jonardan/tapbot/hardware/plotter-5bar/fusion/Plotter5Bar_M4.step

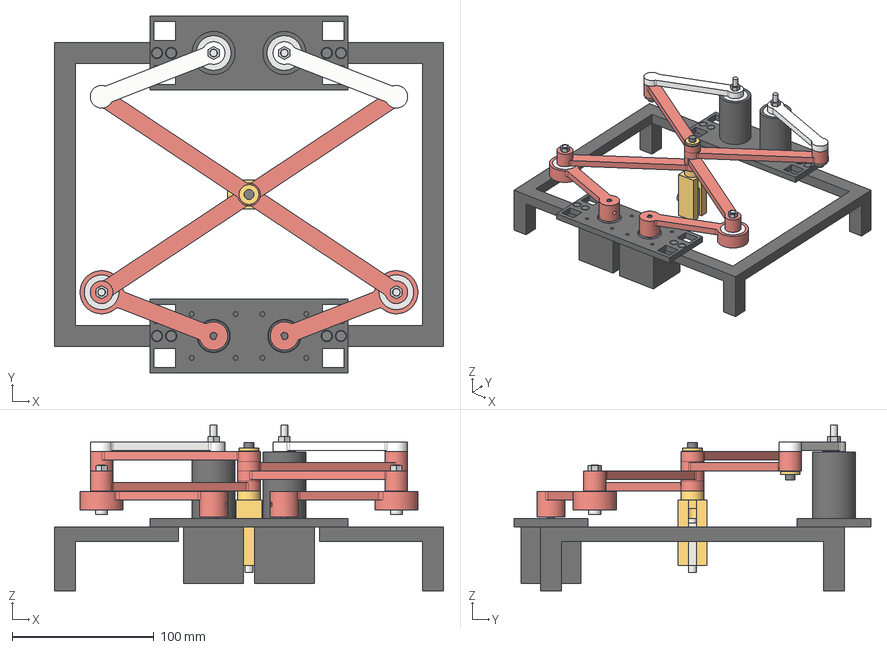
[picture p6: CAD file, 2026-11-05]
hardware/plotter-5bar/fusion/Plotter5Bar_M4.step
275.0 x 252.3 x 117.0 mm
MotorMount
PivotMount
Rail x 2
ProximalArm x 2
DistalArm x 4
PassiveProximalArm x 2
EffectorHub_SolenoidHolder
M5Sleeve x 2
PinCap x 3
PURCHASED_NEMA17 x 2
PURCHASED_Bearing x 4
PURCHASED_Solenoid_JF0530B
PURCHASED_M5x30 x 4
PURCHASED_M5_Nut x 4
PURCHASED_M4x9 x 11
