jonardan/tapbot/hardware/plotter-5bar/stl/1_Struttura/PivotMount_x1.stl

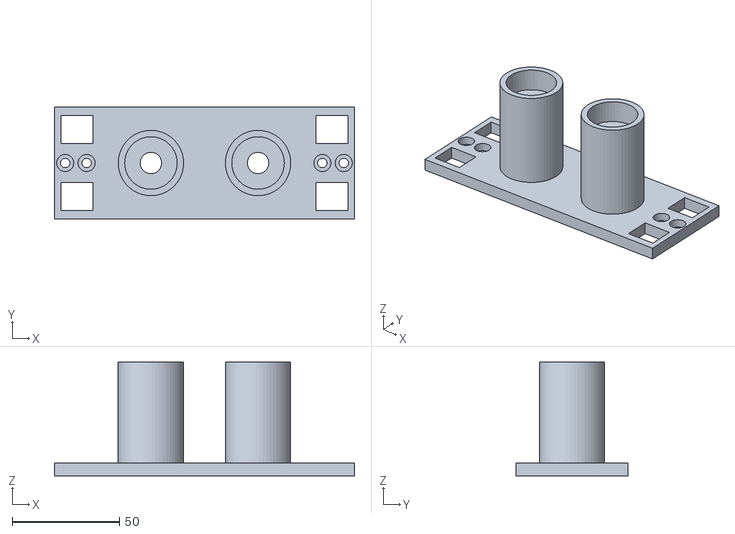
[picture p7: CAD file, 2026-10-31]
hardware/plotter-5bar/stl/1_Struttura/PivotMount_x1.stl
140.0 x 52.3 x 53.0
