jonardan/tapbot/hardware/plotter-5bar/stl/2_Bracci/PIATTO_tutti_i_bracci_8pz.stl

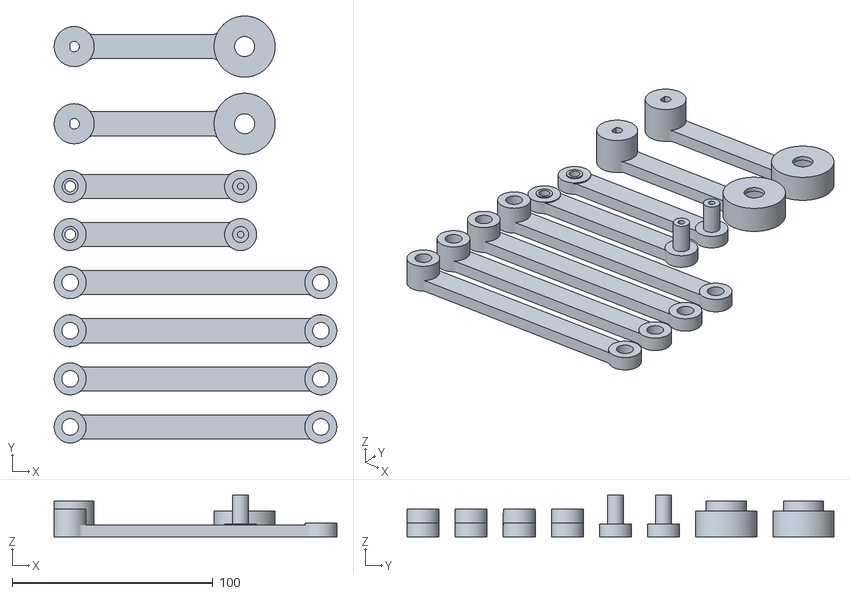
[picture p8: CAD file, 2026-10-31]
hardware/plotter-5bar/stl/2_Bracci/PIATTO_tutti_i_bracci_8pz.stl
141.0 x 212.9 x 20.8
