jonardan/tapbot/hardware/plotter-5bar/stl/3_Effettore/EffectorHub_SolenoidHolder_x1.stl

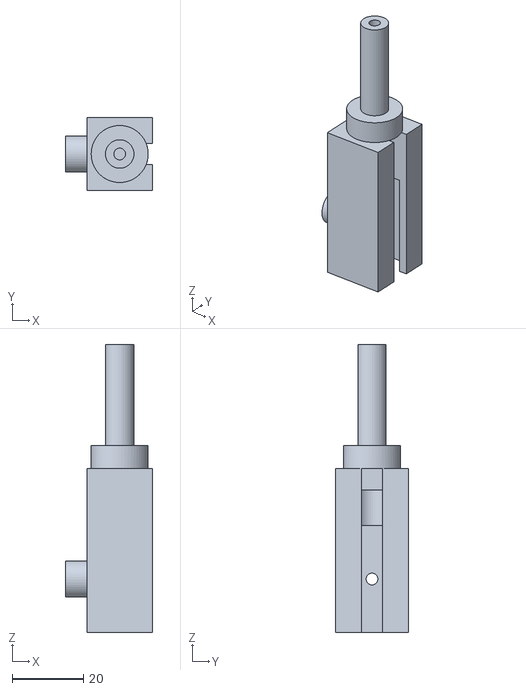
[picture p9: CAD file, 2026-11-05]
hardware/plotter-5bar/stl/3_Effettore/EffectorHub_SolenoidHolder_x1.stl
24.4 x 20.4 x 80.8
