jonardan/tapbot/hardware/plotter-5bar/stl/4_Perni/M5Sleeve_x2.stl

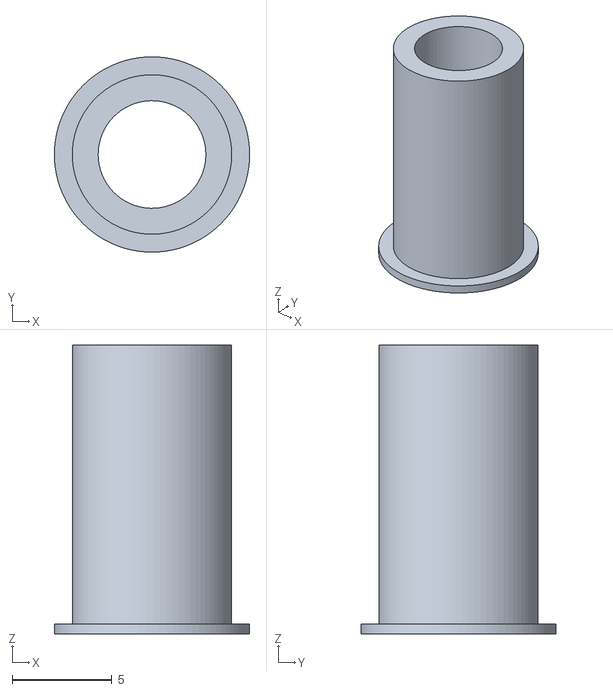
[picture p10: CAD file, 2026-10-31]
hardware/plotter-5bar/stl/4_Perni/M5Sleeve_x2.stl
9.80 x 9.80 x 14.5
