jonardan/tapbot/hardware/plotter-5bar/stl/1_Struttura/Rail_x2.stl

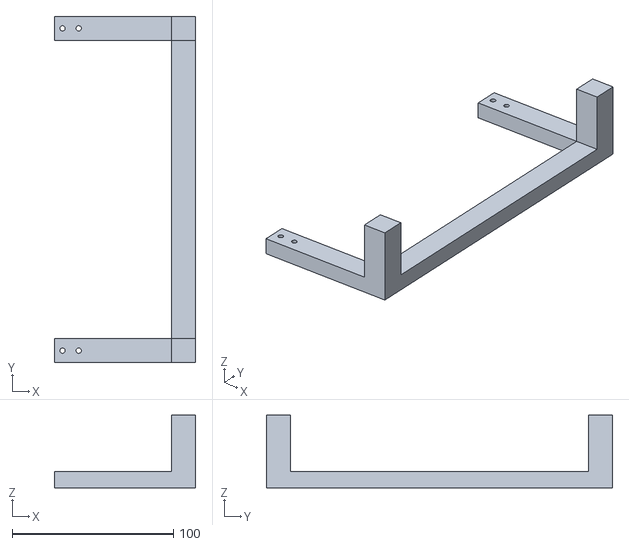
[picture p11: CAD file, 2026-10-31]
hardware/plotter-5bar/stl/1_Struttura/Rail_x2.stl
87.5 x 215.0 x 45.0
