jonardan/tapbot/hardware/plotter-5bar/stl/2_Bracci/ProximalArm_motore_x2.stl

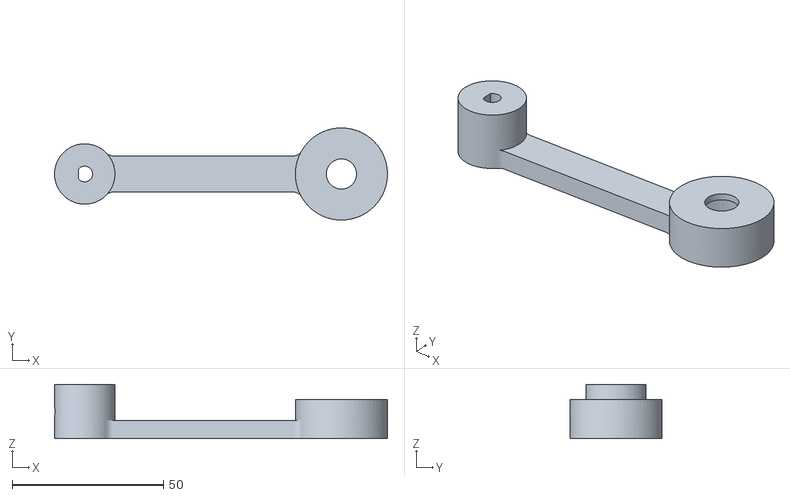
[picture p12: CAD file, 2026-10-31]
hardware/plotter-5bar/stl/2_Bracci/ProximalArm_motore_x2.stl
110.2 x 30.5 x 18.0
