jonardan/tapbot/hardware/plotter-5bar/stl/3_Effettore/PencilHolder_x1.stl

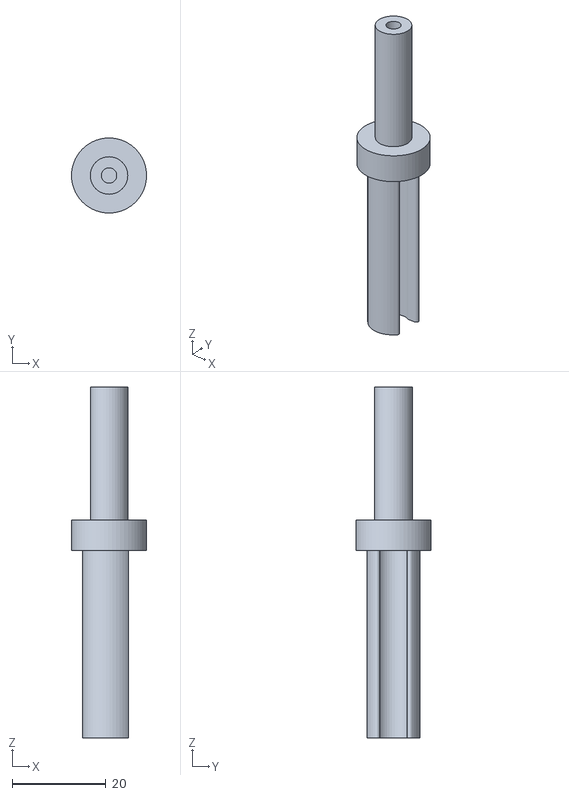
[picture p13: CAD file, 2026-11-02]
hardware/plotter-5bar/stl/3_Effettore/PencilHolder_x1.stl
16.0 x 16.0 x 74.8
