jonardan/tapbot/hardware/plotter-5bar/stl/4_Perni/PinCap_x3.stl

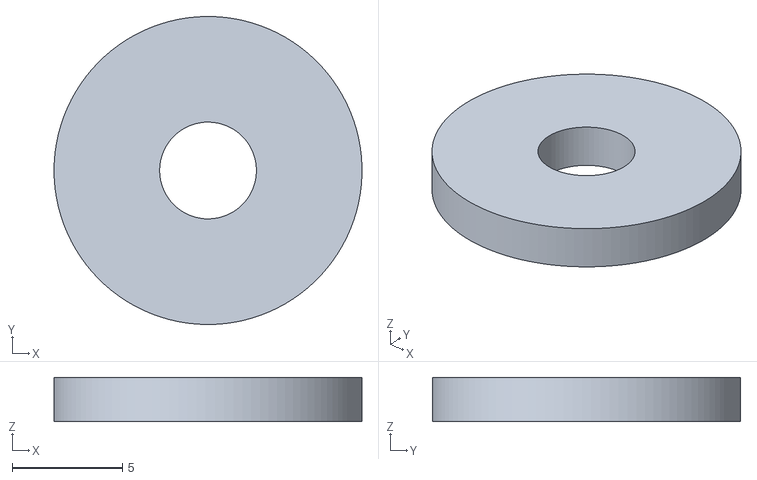
[picture p14: CAD file, 2026-10-31]
hardware/plotter-5bar/stl/4_Perni/PinCap_x3.stl
14.0 x 14.0 x 2.00
