jonardan/tapbot/hardware/plotter-5bar/stl/1_Struttura/MotorMount_x1.stl

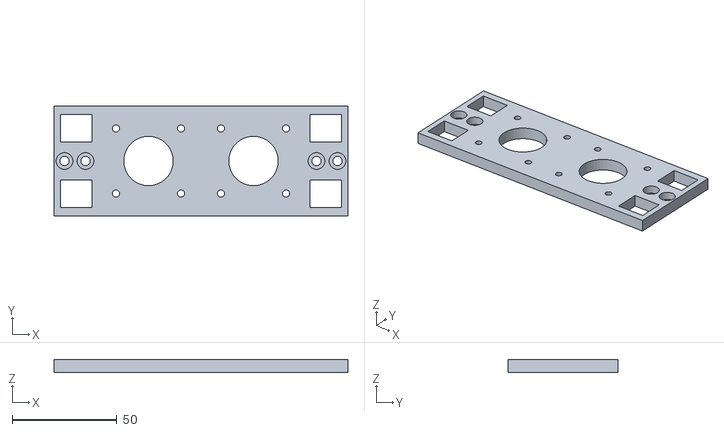
[picture p15: CAD file, 2026-10-31]
hardware/plotter-5bar/stl/1_Struttura/MotorMount_x1.stl
140.0 x 52.3 x 6.00
