jonardan/tapbot/hardware/plotter-5bar/stl/2_Bracci/DistalArm_x4.stl

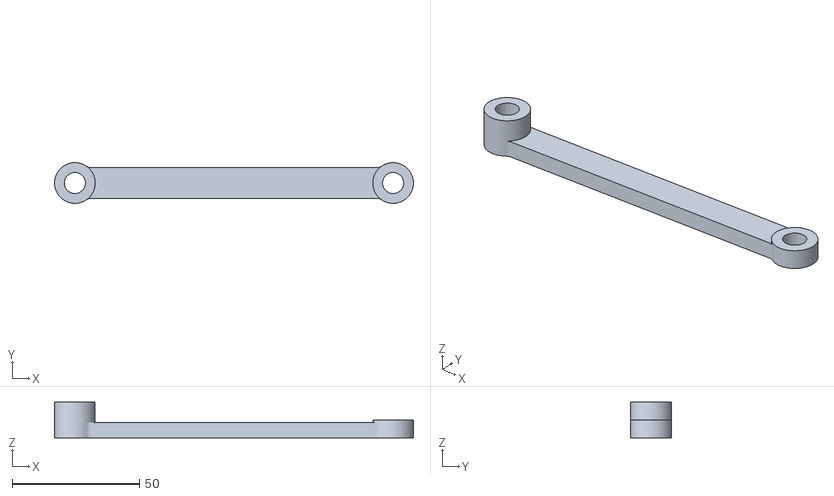
[picture p16: CAD file, 2026-10-31]
hardware/plotter-5bar/stl/2_Bracci/DistalArm_x4.stl
141.0 x 16.0 x 14.0
