jonardan/tapbot/hardware/plotter-5bar/stl/2_Bracci/PassiveProximalArm_x2.stl

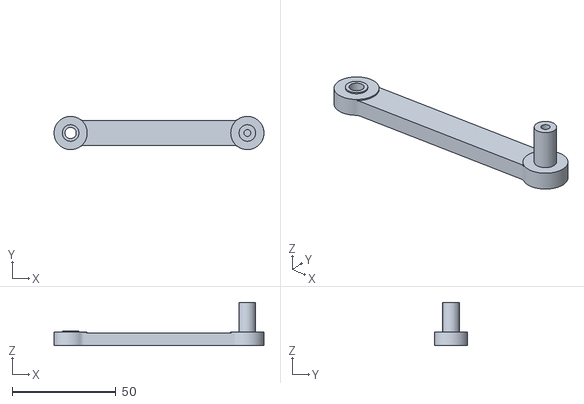
[picture p17: CAD file, 2026-10-31]
hardware/plotter-5bar/stl/2_Bracci/PassiveProximalArm_x2.stl
101.0 x 16.0 x 20.8
