jonardan/tapbot/(list of files, cad)

Other CAD files:
hardware/plotter-5bar/fusion/Plotter5Bar_M4.f3d
