jonardan/tapbot/(commit log)

2026-10-31 tapbot: five-bar XY control for BeagleBone Black + TMC2209
    Buildroot BR2_EXTERNAL tree on the OpenSCARA shield and driver code:
    device tree with only the UART and STEP/DIR pins, tapbot_defconfig,
    and the tapbot package (tapbot + tmc2209ctl, /etc/tapbot.conf).
    fivebar.c: IK/FK of the five-bar (motors 50 mm apart, arms 85 + 125
    mm, elbows out), with checks for the work area, motor limits, flat
    elbows, distal arms in line and the mirrored idler side. path.c:
    straight lines as 1 mm IK segments. Both host-tested (make test).
    No endstops: the tip is in the home corner (-100, 50) at power-on and
    the boot script runs tapbot sethome.
    [genimage.cfg]
2026-10-31 README: what tapbot is, parts, printing, assembly, wiring, flashing
2026-10-31 hardware: parametric Fusion model, STEP and print-ready STLs of the five-bar
    hardware/plotter-5bar/: Plotter5Bar_M4.f3d (User Parameters, one
    component per part, as-built joints with elbow-out limits), a STEP of
    the assembly, the Fusion script that rebuilds the design from scratch,
    and the 18 printed parts as STLs oriented for printing, including one
    bed with all 8 arms.
    README: contents, printed parts table, Z stack, and how to open, edit,
    rebuild, move and re-export the parametric Fusion model.
    [DistalArm_x4.stl, EffectorHub_SolenoidHolder_x1.stl, M5Sleeve_x2.stl, MotorMount_x1.stl, PIATTO_tutti_i_bracci_8pz.stl, PassiveProximalArm_x2.stl, PinCap_x3.stl, PivotMount_x1.stl]
2026-11-01 tapbot.conf: invert both motors, they turned clockwise on a positive turn
2026-11-01 README: the home corner is the work area's, not the frame's
2026-11-02 Home pose: both motor arms along the motor line, left 180 deg, right 0 deg
    The tip is then at (0, 59.37), inside the work area.
2026-11-02 Drawings: tapbot gcode on the board, tools/disegna.html on the PC
    tapbot gcode reads a drawing (G0, G1, M3/M5), checks every millimetre
    of it inside the work area, then runs it in file order: consecutive G1
    lines run as one path up to corner_deg, each stroke announced as
    'stroke K of M'. The page draws freehand, lines, rectangles and
    circles in the 200 x 100 area and sends them over the USB console in
    the order they were drawn.
2026-11-02 disegna.html: the board's terminal in the page, with quick commands
2026-11-02 tapbot.conf: 900 mA and spreadCycle, stealthChop at 500 mA lost steps
2026-11-02 hardware: pencil holder, an alternative effector for a 7 mm pencil
    Same collar and 8 mm pin as the solenoid holder, with a snap-in C-clip
    coaxial with the pin underneath. Added to Plotter5Bar_M4 as the hidden
    component PencilHolder (parameters PencilD, PencilGrip, ClipWall,
    ClipMouth, ClipL); .f3d and STEP re-exported, README parts table and
    notes updated.
    [PencilHolder_x1.stl, Plotter5Bar_M4.f3d, Plotter5Bar_M4.step]
2026-11-05 hardware: open cable slot in the solenoid holder
    The solenoid wires now slide into a slot that runs from the base of the
    holder up to the collar (CableSlotW = 5.8 mm), instead of a closed
    opening. The pencil holder's bore and clip cuts are now limited to the
    pencil holder, so they no longer cut into the solenoid holder.
    STL, .f3d and STEP re-exported.
    [EffectorHub_SolenoidHolder_x1.stl, Plotter5Bar_M4.f3d, Plotter5Bar_M4.step]
